hd890708/roboto_origin/src/motors/src/dm_motor_driver.hpp

#pragma once

#include <atomic>
#include <string>

#include "motor_driver.hpp"
enum DMError {
    DM_DOWN = 0x00,
    DM_UP = 0x01,
    OVER_VOLT = 0x08,
    UNDER_VOLT = 0x09,
    OVER_CURRENT = 0x0A,
    MOS_OVER_TEMP = 0x0B,
    COIL_OVER_TEMP = 0x0C,
    LOST_CONN = 0x0D,
    OVER_LOAD = 0x0E,
};

enum DM_Motor_Model { DM4340_48V, DM10010L_48V, Num_Of_Motor };

enum DM_REG {
    UV_Value = 0,
    KT_Value = 1,
    OT_Value = 2,
    OC_Value = 3,
    ACC = 4,
    DEC = 5,
    MAX_SPD = 6,
    MST_ID = 7,
    ESC_ID = 8,
    TIMEOUT = 9,
    CTRL_MODE = 10,
    Damp = 11,
    Inertia = 12,
    hw_ver = 13,
    sw_ver = 14,
    SN = 15,
    NPP = 16,
    Rs = 17,
    LS = 18,
    Flux = 19,
    Gr = 20,
    PMAX = 21,
    VMAX = 22,
    TMAX = 23,
    I_BW = 24,
    KP_ASR = 25,
    KI_ASR = 26,
    KP_APR = 27,
    KI_APR = 28,
    OV_Value = 29,
    GREF = 30,
    Deta = 31,
    V_BW = 32,
    IQ_c1 = 33,
    VL_c1 = 34,
    can_br = 35,
    sub_ver = 36,
    u_off = 50,
    v_off = 51,
    k1 = 52,
    k2 = 53,
    m_off = 54,
    dir = 55,
    p_m = 80,
    xout = 81,
};

typedef struct {
    float PosMax;
    float SpdMax;
    float TauMax;
} Limit_param;

class DmMotorDriver : public MotorDriver {
   public:
    DmMotorDriver(uint16_t motor_id, std::string can_interface, uint16_t master_id_offset,
                  DM_Motor_Model motor_model);
    ~DmMotorDriver();

    virtual void MotorLock() override;
    virtual void MotorUnlock() override;
    virtual uint8_t MotorInit() override;
    virtual void MotorDeInit() override;
    virtual bool MotorSetZero() override;
    virtual bool MotorWriteFlash() override;

    virtual void MotorGetParam(uint8_t param_cmd) override;
    virtual void MotorPosModeCmd(float pos, float spd, bool ignore_limit) override;
    virtual void MotorSpdModeCmd(float spd) override;
    virtual void MotorMitModeCmd(float f_p, float f_v, float f_kp, float f_kd, float f_t) override;
    virtual void MotorResetID() override {};
    virtual void set_motor_control_mode(uint8_t motor_control_mode) override;
    virtual int get_response_count() const {
        return response_count_;
    }
    virtual void refresh_motor_status() override;
    virtual void clear_motor_error() override;

   private:
    std::atomic<int> response_count_{0};
    bool param_cmd_flag_[30] = {false};
    const float KpMin = 0.0f;
    const float KpMax = 500.0f;
    const float KdMin = 0.0f;
    const float KdMax = 5.0f;
    DM_Motor_Model motor_model_;
    Limit_param limit_param_;
    std::atomic<uint8_t> mos_temperature_{0};
    std::string can_interface_;
    void DmMotorSetZero();
    void DmMotorClearError();
    void DmWriteRegister(uint8_t rid, float value);
    void DmWriteRegister(uint8_t rid, int32_t value);
    void DmSaveRegister(uint8_t rid);
    virtual void CanRxMsgCallback(const can_frame& rx_frame) override;
    std::shared_ptr<SocketCAN> can_;
};
