hd890708/roboto_origin/modules/atom01_deploy/imu/src/drivers/hipnuc/canopen_parser.h

#ifndef C8147439_363C_4296_AECA_89DFD398EEA7
#define C8147439_363C_4296_AECA_89DFD398EEA7
#ifndef CANOPEN_PARSER_H
#define CANOPEN_PARSER_H

#include "hipnuc_can_common.h"

int canopen_parse_frame(const hipnuc_can_frame_t *frame, can_sensor_data_t *data);

#endif


#endif /* C8147439_363C_4296_AECA_89DFD398EEA7 */
