hd890708/roboto_origin/(commit log)

2026-01-20 Squashed 'modules/atom01_deploy/motors/' content from commit 39673ed
    git-subtree-dir: modules/atom01_deploy/motors
    git-subtree-split: 39673eda88610da165e240791bc6e797ef8e54d4
    [motors.yaml]
2026-01-21 Squashed 'modules/atom01_deploy/motors/' changes from 39673ed..b746ad4
    b746ad4 Merge pull request #1 from wentywenty/master
    8107fa2 Merge branch 'Luo1imasi:master' into master
    143a3bb fix evo compline
    499bfc9 add evo motor
    git-subtree-split: b746ad448c7a729030196056c2e97593141e71fe
    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
    [motors.yaml]
2026-01-30 chore: 将 .scripts 目录从仓库跟踪中移除（保留本地文件）
